VladVeliciu/Soil-Quality-Sensor/Schematics.PDF

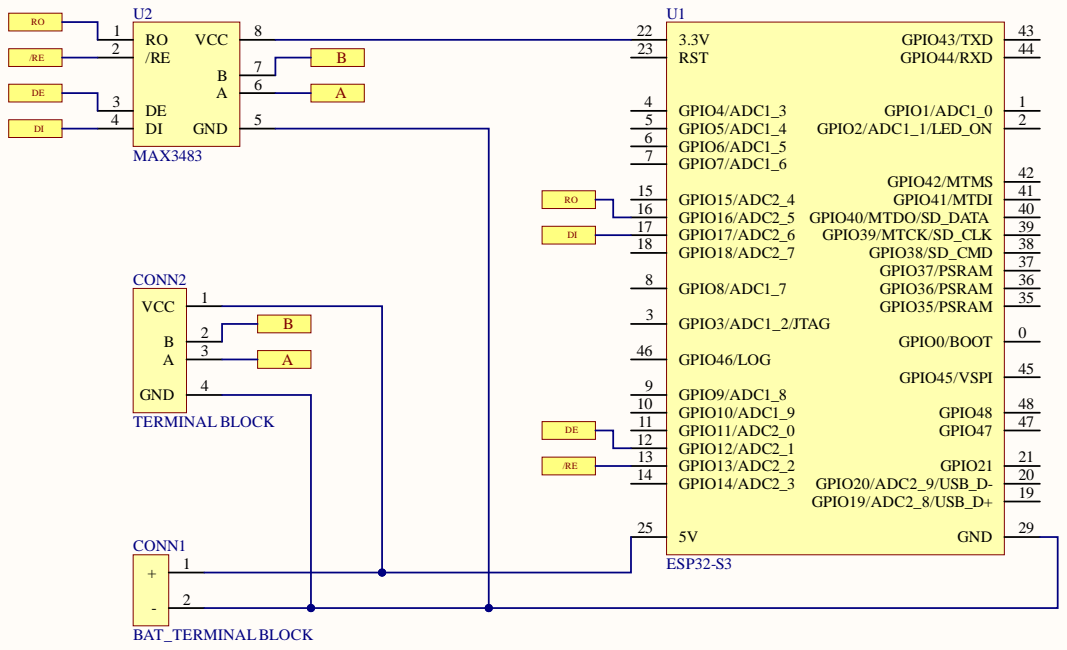
[picture p16: page 1]

/RE 2 | RST 23
